zhangchh/esp32c3-4ch-led-dimmer/docs/3D_PCB1_2026-11-05.png

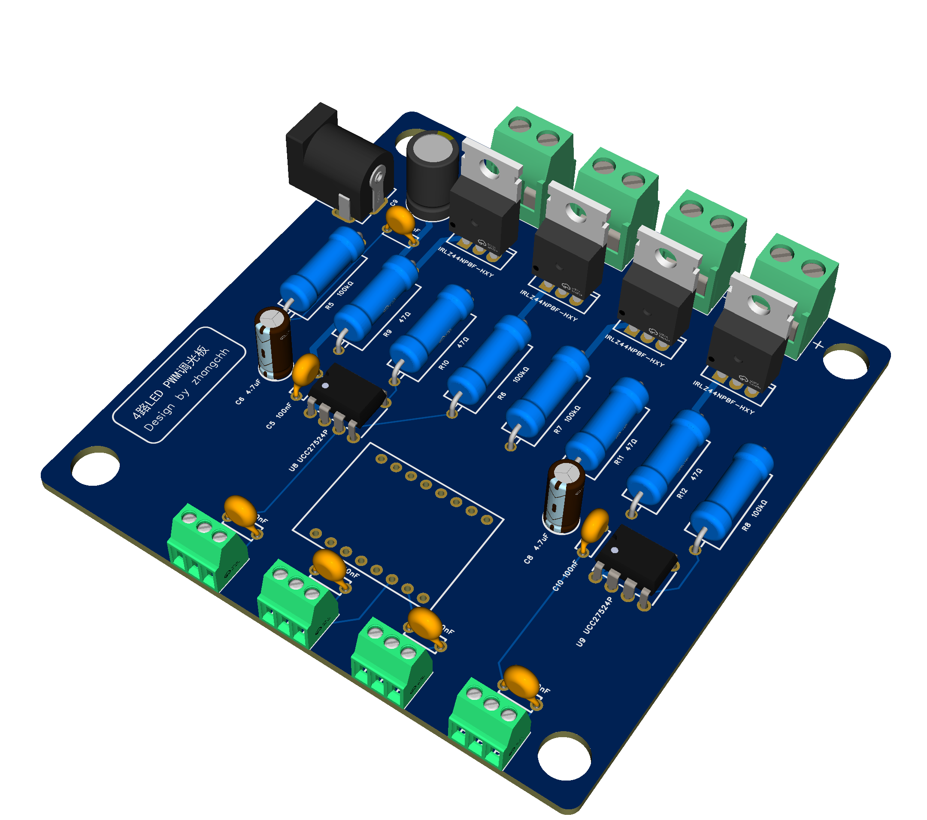
docs/3D_PCB1_2026-11-05.png
