zhangchh/esp32c3-4ch-led-dimmer/docs/原理图.png

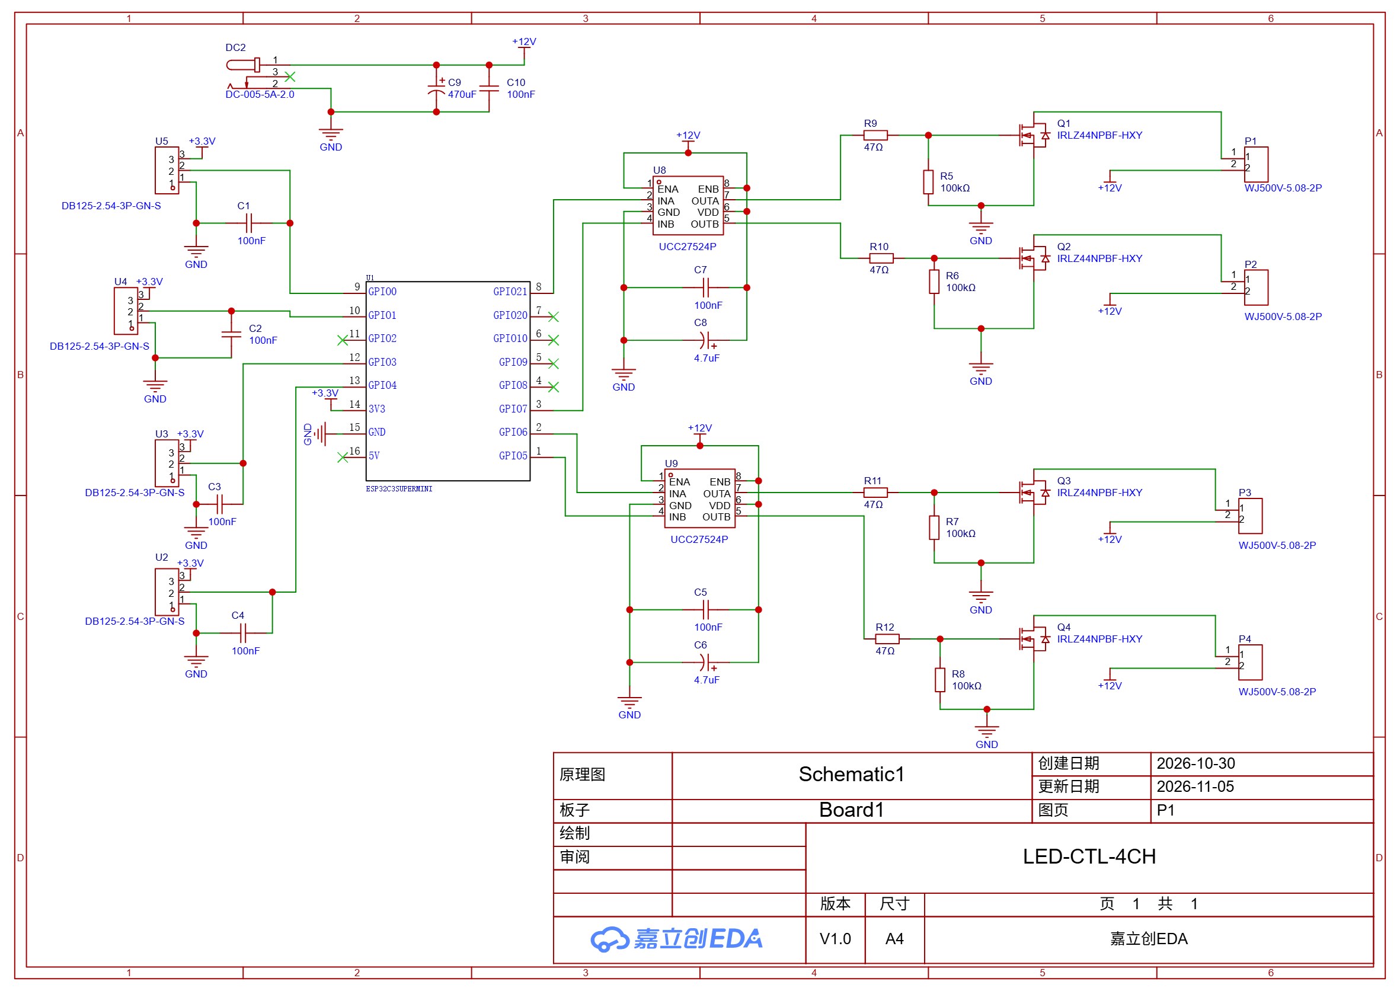
docs/原理图.png
