zhangchh/esp32c3-4ch-led-dimmer/docs/BOM.xlsx

No. | Quantity | Comment | Designator | Footprint | Value | Manufacturer Part | Manufacturer | Supplier Part | Supplier
1 | 7 | 100nF | C1,C2,C3,C4,C5,C7,C10 | CAP-TH_L5.0-W2.5-P5.00-D1.0 | 100nF | CC1H104MC1FD3F6C10MF | Dersonic(德尔创) | C254085 | LCSC
2 | 2 | 4.7uF | C6,C8 | CAP-TH_BD5.0-P2.00-D0.5-FD_H11.0 | 4.7uF | ERG50V4R7M5X11 | JIERR(捷而瑞) | C51904470 | LCSC
3 | 1 | 470uF | C9 | CAP-TH_BD8.0-P3.50-D0.5-FD | 470uF | ERA25V470M8X12 | JIERR(捷而瑞) | C49256797 | LCSC
4 | 1 | DC-005-5A-2.0 | DC2 | DC-IN-TH_DC-005-5A-2.0 |  | DC-005-5A-2.0 | XKB Connection(中国星坤) | C381116 | LCSC
5 | 4 | WJ500V-5.08-2P | P1,P2,P3,P4 | CONN-TH_2P-P5.00_WJ500V-5.08-2P |  | WJ500V-5.08-2P | KANGNEX(康奈克斯电气) | C8465 | LCSC
6 | 4 | IRLZ44NPBF-HXY | Q1,Q2,Q3,Q4 | TO-220-3_L9.9-W4.5-P2.54-L-1 |  | IRLZ44NPBF-HXY | HXY MOSFET(华轩阳电子) | C22367197 | LCSC
7 | 4 | 100kΩ | R5,R6,R7,R8 | RES-TH_BD5.5-L15.0-P19.00-D0.8 | 100kΩ | MFR03SF220JA10 | UNI-ROYAL(厚声) |  | LCSC
8 | 4 | 47Ω | R9,R10,R11,R12 | RES-TH_BD5.5-L15.0-P19.00-D0.8 | 47Ω | MFR03SF220JA10 | UNI-ROYAL(厚声) |  | LCSC
9 | 1 | ESP32C3SUPERMINI | U1 | ESP32C3SUPERMINI | U1
10 | 4 | DB125-2.54-3P-GN-S | U2,U3,U4,U5 | CONN-TH_DB125-2.54-3P-GN |  | DB125-2.54-3P-GN-S | DORABO(地博电气) | C918121 | LCSC
11 | 2 | UCC27524P | U8,U9 | PDIP-8_L9.3-W6.4-P2.54-LS7.6-BL |  | UCC27524P | TI(德州仪器) | C1549444 | LCSC
