zhangchh/esp32c3-4ch-led-dimmer/(commit log)

2026-11-05 初始提交：4 路 LED 灯带 PWM 调光固件（ESP32-C3 SuperMini）
    固件
    - 4ch_led_dimmer/4ch_led_dimmer.ino
    - 引脚：ADC IO0/IO1/IO3/IO4，PWM IO21/IO7/IO6/IO5（严格按 v3 原理图）
    - 4 kHz / 12-bit LEDC，gamma 2.2，EMA 低通 + 斜率限制，占空比 <2% 置零
    - NVS 两点标定 + 串口 CLI（status / cal / off / on / gamma）
    - 兼容 Arduino-ESP32 3.x（ledcAttach）与 2.x（ledcSetup/ledcAttachPin）
    测试
    - 4ch_led_dimmer/test/：mock Arduino 的主机端单元测试，24 项
    bash 4ch_led_dimmer/test/run_test.sh
    文档
    - README.md：原理图解读、引脚表、烧录、标定、上电自检、排障
    - docs/4-channel-led-pwm-wiring-v3.html：v3 原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
2026-11-05 提交原理图+示意图
    [BOM.xlsx]
2026-11-05 提交gerber文件
